JasonLiaoJCS/RPL_HW1/hardware/diagrams/17HS4023.png

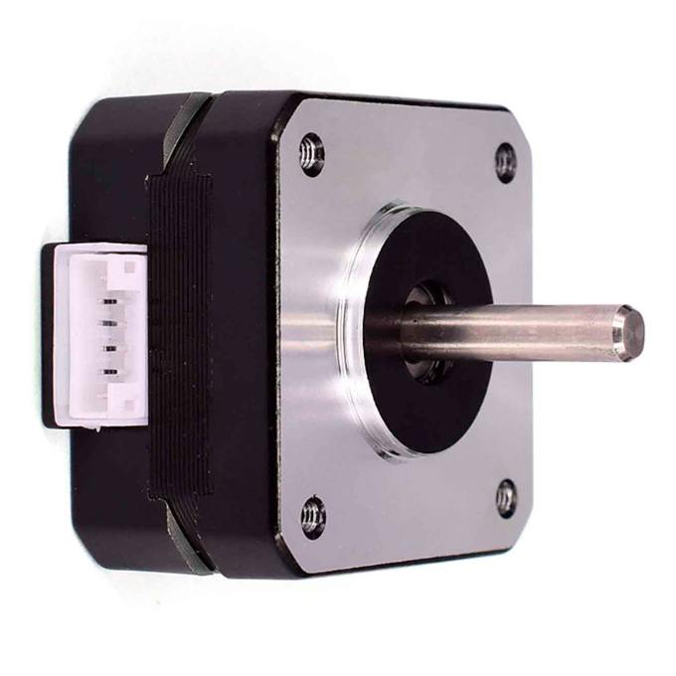
hardware/diagrams/17HS4023.png
