JasonLiaoJCS/RPL_HW1/hardware/diagrams/Arduino Nano.png

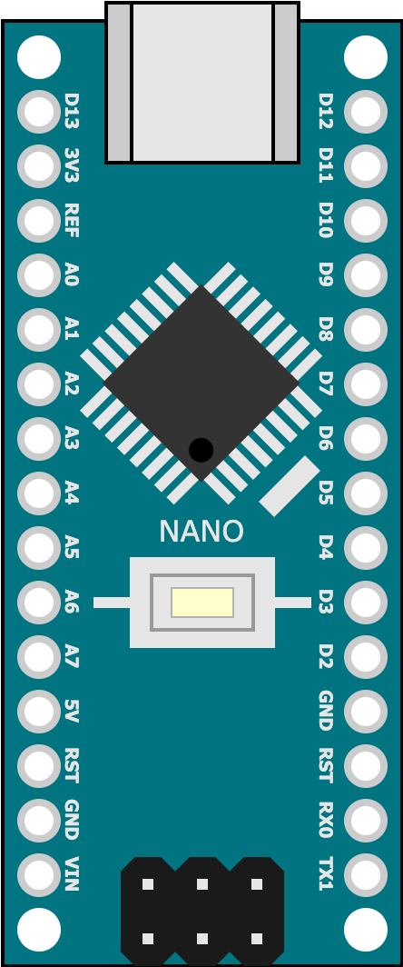
hardware/diagrams/Arduino Nano.png
