JasonLiaoJCS/RPL_HW1/hardware/diagrams/DRV8825.png

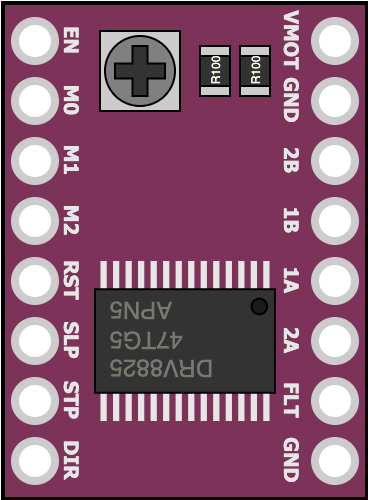
hardware/diagrams/DRV8825.png
