JasonLiaoJCS/RPL_HW1/hardware/meshes/motor plate.stl

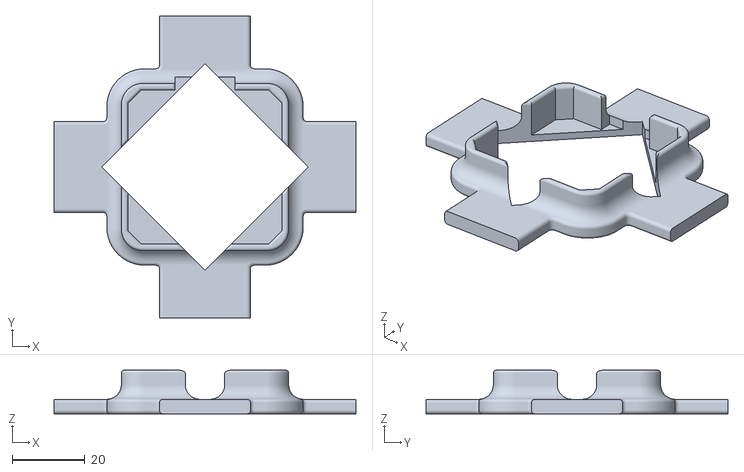
[picture p5: CAD file, 2026-10-07]
hardware/meshes/motor plate.stl
83.0 x 83.0 x 12.0
