JasonLiaoJCS/RPL_HW1/hardware/meshes/base.stl

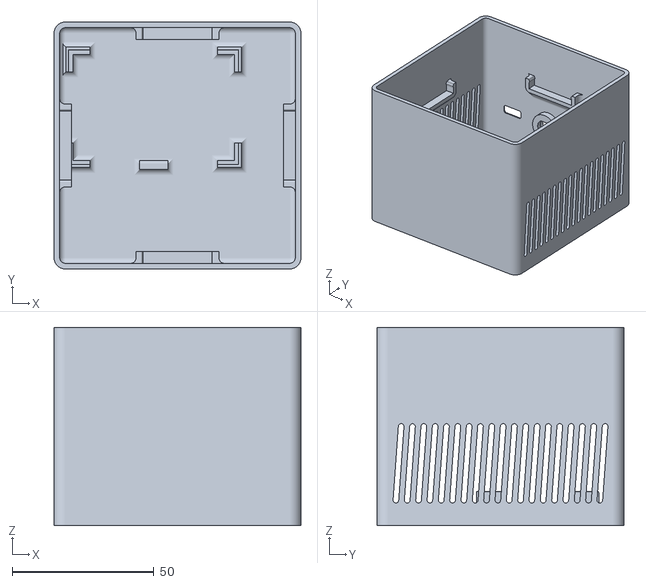
[picture p6: CAD file, 2026-10-07]
hardware/meshes/base.stl
87.2 x 87.2 x 70.0
