JasonLiaoJCS/RPL_HW1/hardware/meshes/arm.stl

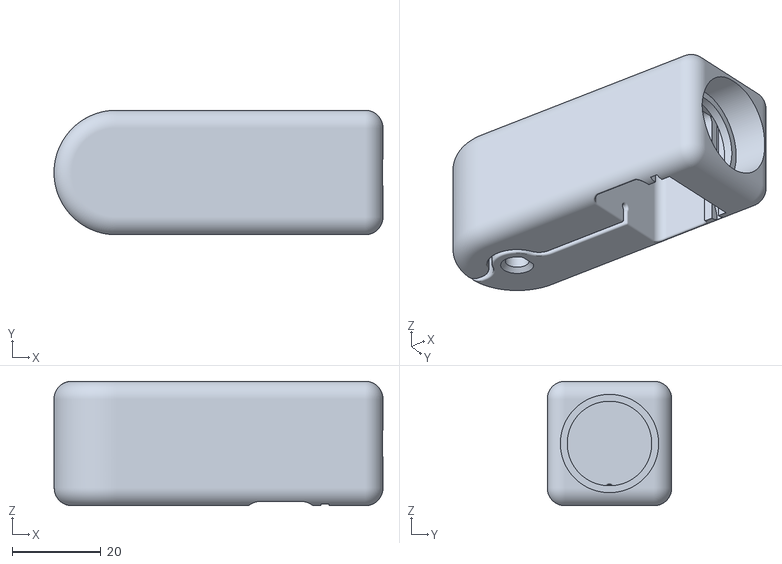
[picture p7: CAD file, 2026-10-07]
hardware/meshes/arm.stl
74.0 x 28.0 x 28.0
