JasonLiaoJCS/RPL_HW1/hardware/meshes/lid.stl

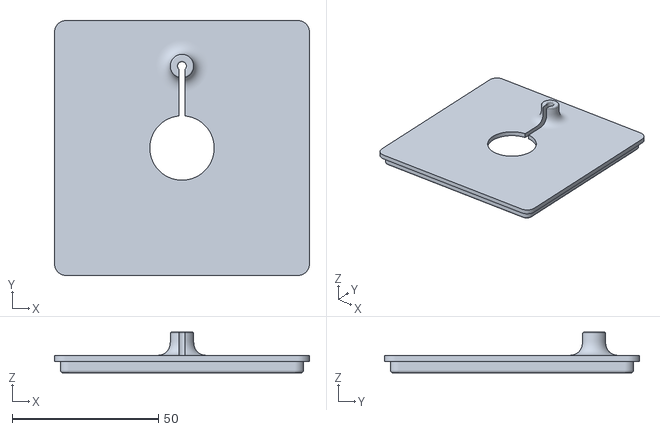
[picture p8: CAD file, 2026-10-07]
hardware/meshes/lid.stl
87.2 x 87.2 x 14.0
