JasonLiaoJCS/RPL_HW1/hardware/meshes/pendulum.stl

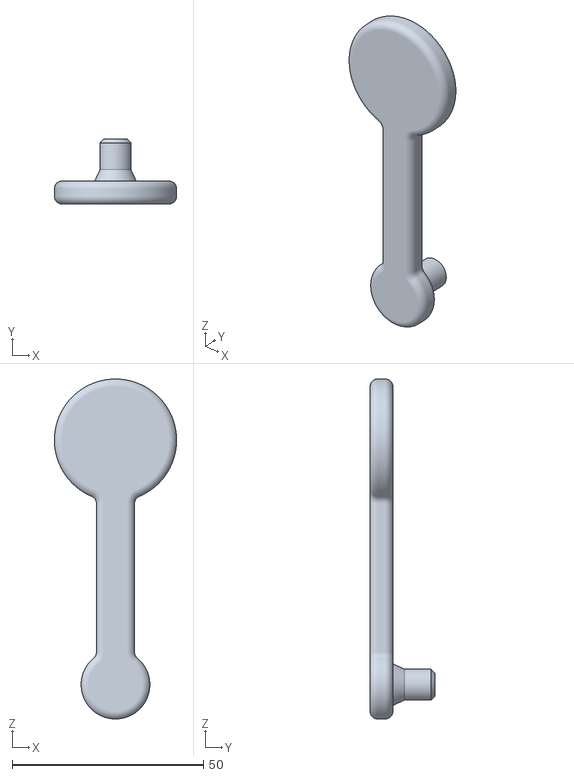
[picture p9: CAD file, 2026-10-07]
hardware/meshes/pendulum.stl
32.0 x 17.0 x 89.0
